newmatik-old/ntimer/README.md

# ntimer
Hard and Software for ERPNext time recording

We are working on the readme, meanwhile check out
`Ntimer API Documentation.docx`, `Ntimer Setup.docx` and the discussion post on the 
ERPNext forum here https://discuss.erpnext.com/t/hardware-employee-time-tracking-with-rfid-chips/39166/48
