newmatik-old/ntimer/Ntimer API Documentation.docx

# Ntimer API Documentation

Important: all API calls must be made by “Post” and can not be done by “Get”.

All responses are enveloped in a "message": [{ array }]

Example:

"message": [{

"status": "error",

"error_message": “RFID tag unknown."

}]

# Logging In

## API Call:

Logging In:

/api/method/login?usr=user&pwd=password

## Possible outcome:

- Logged in: "message": "Logged In"
- Not logged in: long HTML response with text “Your session has expired, please login again to continue". This could mean wrong username or password.

# Punch In or Punch Out:

## API Call:

Punch In:

/api/method/erpnext.hr.doctype.employee_checkin.employee_checkin.punch_in?rfid_tag=tag

Punch Out:

/api/method/erpnext.hr.doctype.employee_checkin.employee_checkin.punch_out?rfid_tag=tag

## Possible errors:

This RFID Tag is not set in any employee DocType.

"status": "error",

“error_message": “RFID tag unknown."

The employee is not active in the employee DocType.

“status": “error",

“error_message": “Employee not active."

Can not punch in because employee is already punched in.

“status": “error",

“error_message": “Already punched in."

Can not punch out because employee is not punched in.

“status": “error",

“error_message": “Not punched in."

Positive result punch In:

"status": "success",

"in_time": "2018-08-24 10:18:36",

"employee_name": "Michael Miller",

“rfid_tag": “123456789"

Positive result punch out:

"status": "success",

"out_time": "2018-08-24 10:23:24",

"in_time": "2018-08-24 10:18:00",

"employee_name": "Michael Miller",

"duration": "0:05:24",

"rfid_tag": "123456789"
