newmatik-old/ntimer/Hardware/Assembly and Fabrication files/Ntimer_Project_v1.0_BOM.xlsx

Designator | Comment | Manufacturer Part Number | Footprint | Quantity
C1, C2, C13, C14 | 22pF | 885012006004 | C0603 | 4
C3, C4, C5, C6, C7, C8, C9, C10, C11, C16, C17, C22, C23, C24, C25, C26, C27, C28, C29, C39, C40 | 100nF | CL10F104ZO8NNNC | C0603 | 21
C12, C52, C53 | 1uF | CL10A105KQ8NNNC | C0603 | 3
C15, C33 | 4.7uF | C1608X5R1C475M080AC, CL10A475MP5LNNC | C0603 | 2
C18, C19 | 22uF | CL10A226MQ8NRNC | C0603 | 2
C20 | 56pF | CL10C560JB8NNNC | C0603 | 1
C21 | 10uF | JMK107ABJ106MA-T | C0603 | 1
C30 | 22nF | CL10B223KA8NNWC | C0603 | 1
C31, C32 | 6.8nF | CL10B682KB8SFNC | C0603 | 2
C34, C35 | 10nF | VJ0603Y103KXQCW1BC | C0603 | 2
C36 | 1nF/2kV | C1206C102KGRACAUTO | R1206 | 1
C37, C38, C42, C49 | 18pF | VJ0603A180JXACW1BC | C0603 | 4
C41 | 1nF | CL10B102JB8NNNC | C0603 | 1
C43, C46, C54, C55 | 220pF | 885012206030 | C0603 | 4
C44, C47 | 47pF | 885012006021 | C0603 | 2
C45, C48 | 6.8pF | CL10C6R8DB8NNNC | C0603 | 2
C50, C51 | 15pF | CL10C150JC8NNNC | C0603 | 2
D1, D6 | 1N4148WT-7 | 1N4148WT-7 | SOD523 | 2
D2 | LED | LTST-S220GKT | LED0805 | 1
D3 | TX | LTST-S220GKT | LED0805 | 1
D4 | RX | LTST-C171KRKT | LED0805 | 1
D5 | 3V3 | LTST-S220GKT | LED0805 | 1
DS1 | NHD-C0220BIZ-FSW-FBW-3V3M | NHD-C0220BIZ-FSW-FBW-3V3M | NHD-C0220BIZ-FSW-FBW-3V3M | 1
J1 | PJ-037AH | PJ-037AH | CON_PJ-037A | 1
L1, L3, L4 | 120R | BLM18PG121SN1D | L0603 | 3
L2 | 10uH/3.4A/61m | VLS6045EX-100M | IND6045 | 1
L5, L6 | 560nH | AIML-0603-R56K-T | L0603 | 2
LS1 | PIEZO 65dB @ 1.5V, 10cm | PKMCS0909E4000-R1 | PIEZO_XDCR_PKMCS0909E4000-R1 | 1
P1 | ICSP | 5-146254-3 | HDR2X3 | 1
P2 | ICSP USB | 5-146254-3 | HDR2X3 | 1
P3 | Micro USB | 1051330011 | CON_MOLEX_105133-0011 | 1
P4 | RJMG1BD3B8K1ANR | RJMG1BD3B8K1ANR | CONN_RJMG1BD3B8K1ANR_RJMG1BD3B8K1ANR(Primary) | 1
P5 | 0472192001 | 0472192001 | MICROSD_MOLEX_0472192001 | 1
Q1, Q2 | MMBT3904-TP | MMBT3904-TP | SOT23-3 | 2
R1, R2 | 0R/DNP | CR0603-J/-000ELF | R0603 | 2
R3, R4, R25, R26, R27, R36, R42, R43, R44, R46 | 10k | RMCF0603FT10K0 | R0603 | 10
R5, R6, R9, R17, R37, R41, R45 | 1k | RMCF0603FG1K00 | R0603 | 7
R7, R8 | 22R | CRGCQ0603J22R | R0603 | 2
R10, R12, R13, R21, R33 | 330R | RMCF0603JT330R | R0603 | 5
R11, R35 | 1M | RMCF0603FG1M00 | R0603 | 2
R14 | 511k | RMCF0603FT511K | R0603 | 1
R15 | 105k | RMCF0603FT105K | R0603 | 1
R16, R22, R23, R31, R32 | 49.9R | RMCF0603FT49R9 | R0603 | 5
R18 | 100k | CR0603-JW-104ELF | R0603 | 1
R19 | 22.1k | RNCP0603FTD22K1 | R0603 | 1
R20 | 10R | RMCF0603JT10R0 | R0603 | 1
R24, R28, R29, R30 | 0R | CR0603-J/-000ELF | R0603 | 4
R34 | 12.4k | RMCF0603FT12K4 | R0603 | 1
R38 | 5.36k | CR0603-FX-5361ELF | R0603 | 1
R39, R40 | 4.7k | RMCF0603JT4K70 | R0603 | 2
R47, R48 | 3.3R | CRGCQ0603J3R3 | R0603 | 2
S1 | SPST-NO | PTS645SM43SMTR92 LFS | DPST-4 | 1
S2 | SPST-NO | D6R50 F1 LFS | BUTTON_D6R90_GREEN | 1
S3 | SPST-NO | D6R40 F1 LFS | BUTTON_D6R90_RED | 1
U1 | ATMEGA2560-16AU | ATMEGA2560-16AU | TQFP100 | 1
U2 | ATMEGA16U2-AU | ATMEGA16U2-AU | 32A_N | 1
U3 | TPS54202DDCT | TPS54202DDCT | SOT23-6 | 1
U4 | W5500 | W5500 | QFP50P700X700X160-48N | 1
U5 | MFRC52201HN1,157 | MFRC52201HN1,157 | QFN-32_5x5_0.5 | 1
Y1, Y2 | XTAL 16MHz | ABLS-16.000MHZ-B2-T | XTAL-SMD | 2
Y3 | 25MHz | ABM3-25.000MHZ-D2Y-T | CRYSTAL-AMB3_5X3.2_1.3 | 1
Y4 | XTAL 27.12MHz | 9C-27.120MAAJ-T | XTAL-SMD | 1
