newmatik-old/ntimer/Case/case/PCB case.SLDASM

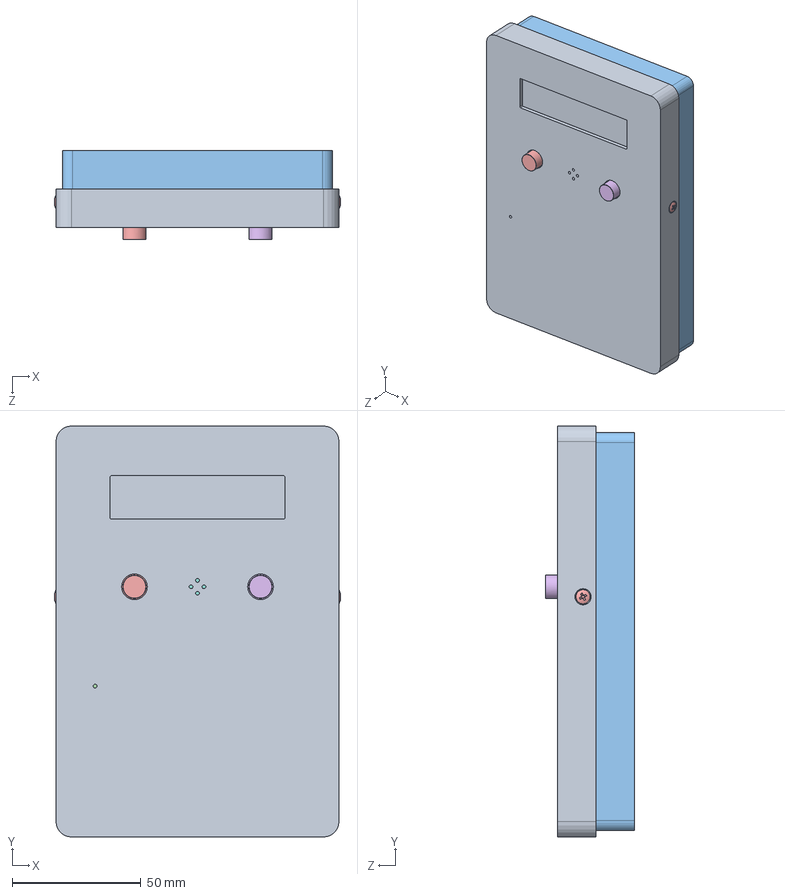
[picture p1: CAD file, 2018-10-25]
Case/case/PCB case.SLDASM
111.3 x 159.8 x 34.6 mm
case front
Board
C0603 x 54
R0603 x 48
User_Library-RES_3216-1206
User_Library-SOD-523F x 2
User_Library-User_Library-led_0805_GRE x 4
1112W-3
LCD
PRT0001 x 8
PJ-037A
PJ-037A_2
PJ-037A_3
User_Library-Chip_Inductor_0603 x 5
User_Library-Inductor_VLC6045_Series
PKMCS0909E4000-R1--3DModel-STEP-56544
SOT-23 x 2
b3s-1000
D6R90F1LFS_RGB65280
D6R90F1LFS_RGB255
User_Library-TQFP100_Grid_0.5_TQFP100_Koerper_2
User_Library-TQFP100_Grid_0.5_TQFP_PIN_2 x 100
SW3dPS-SW3dPS-atmega8_(tqfp32)_V2008
User_Library-SOT23-6-2
User_Library-WIZNET_W5500
User_Library-qfn32-5x5____________
ABLS x 3
User_Library-ABM3_BodyBase
User_Library-ABM3_TopCap
User_Library-ABM3_Pocket001
User_Library-ABM3_Pocket
User_Library-J1B1211CCD
case back
pan head cross recess screw_iso x 4
countersunk raised head cross recess screw_iso x 2
