newmatik-old/ntimer/Case/case/case back.SLDPRT

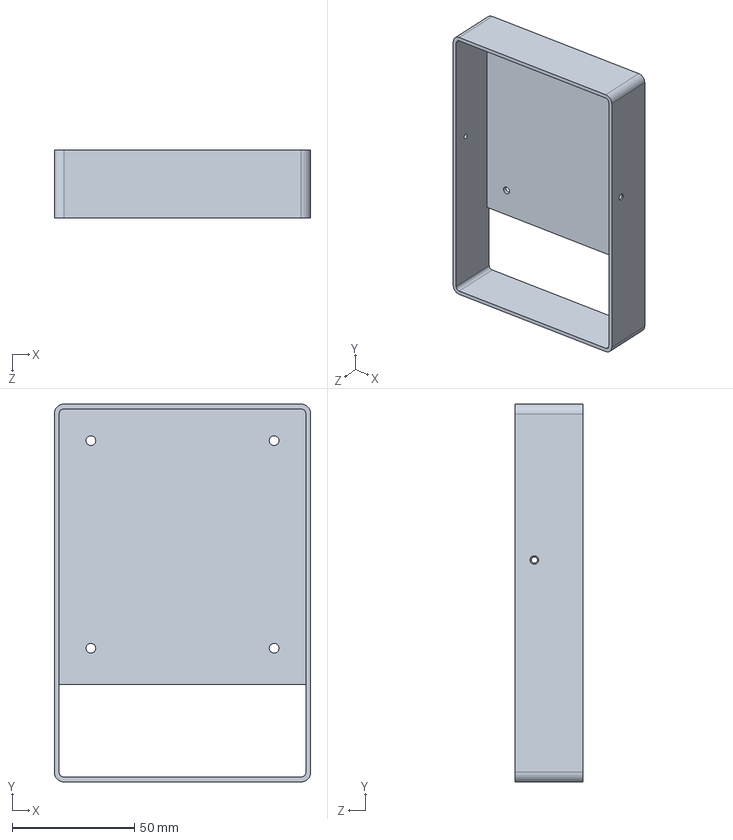
[picture p3: CAD file, 2018-10-25]
Case/case/case back.SLDPRT
105.0 x 154.8 x 28.0 mm
