newmatik-old/ntimer/Case/case/case front.SLDPRT

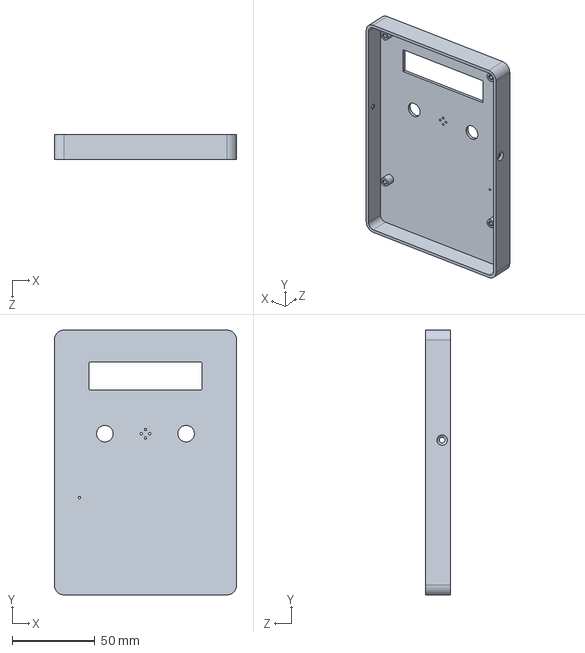
[picture p4: CAD file, 2018-10-25]
Case/case/case front.SLDPRT
110.0 x 159.8 x 15.0 mm
