newmatik-old/ntimer/(list of files, cad)

Other CAD files:
Case/model/U2.sldasm
Case/model/R24.sldasm
Case/model/S2.sldasm
Case/model/C23.sldasm
Case/model/C34.sldasm
Case/model/C43.sldasm
Case/model/S1.sldasm
Case/model/R9.sldasm
Case/model/R23.sldasm
Case/model/U3.sldasm
Case/model/R26.sldasm
Case/model/R34.sldasm
Case/model/R32.sldasm
Case/model/P5.sldasm
Case/model/C32.sldasm
Case/model/R11.sldasm
Case/model/C31.sldasm
Case/model/P4.sldasm
Case/model/C35.sldasm
Case/model/C21.sldasm
Case/model/C39.sldasm
Case/model/C30.sldasm
Case/model/C1.sldasm
Case/model/C9.sldasm
Case/model/C13.sldasm
Case/model/C27.sldasm
Case/model/D5.sldasm
Case/model/C12.sldasm
Case/model/R19.sldasm
Case/model/R6.sldasm
Case/model/R2.sldasm
Case/model/Q2.sldasm
Case/model/L5.sldasm
Case/model/R40.sldasm
Case/model/P3.sldasm
Case/model/Y3.sldasm
Case/model/L2.sldasm
Case/model/Y1.sldasm
Case/model/C49.sldasm
Case/model/L4.sldasm
Case/model/C7.sldasm
Case/model/D3.sldasm
Case/model/Y4.sldasm
Case/model/R30.sldasm
Case/model/C52.sldasm
Case/model/C40.sldasm
Case/model/C2.sldasm
Case/model/R42.sldasm
Case/model/R18.sldasm
Case/model/R27.sldasm
Case/model/R41.sldasm
Case/model/C37.sldasm
Case/model/C47.sldasm
Case/model/C44.sldasm
Case/model/C24.sldasm
Case/model/U1.sldasm
Case/model/C51.sldasm
Case/model/Q1.sldasm
Case/model/R44.sldasm
Case/model/U5.sldasm
Case/model/C15.sldasm
Case/model/DS1.sldasm
Case/model/C26.sldasm
Case/model/R10.sldasm
Case/model/C0603.sldasm
Case/model/LS1.sldasm
Case/model/R16.sldasm
Case/model/R47.sldasm
Case/model/C36.sldasm
Case/model/R39.sldasm
Case/model/R28.sldasm
Case/model/R4.sldasm
Case/model/R33.sldasm
Case/model/R14.sldasm
Case/model/R43.sldasm
Case/model/R48.sldasm
Case/model/U4.sldasm
Case/model/R35.sldasm
Case/model/C11.sldasm
Case/model/User_Library-ABM3.sldasm
Case/model/D6.sldasm
Case/model/R25.sldasm
Case/model/C41.sldasm
Case/model/R46.sldasm
Case/model/C16.sldasm
Case/model/C3.sldasm
Case/model/C28.sldasm
Case/model/C53.sldasm
Case/model/R37.sldasm
Case/model/R17.sldasm
Case/model/C38.sldasm
Case/model/R7.sldasm
Case/model/Y2.sldasm
Case/model/L3.sldasm
Case/model/C17.sldasm
Case/model/R36.sldasm
Case/model/L6.sldasm
Case/model/C55.sldasm
Case/model/C5.sldasm
Case/model/C4.sldasm
Case/model/NHD-C0220BiZ-FSW-FBW-3V3M.sldasm
Case/model/SOT-23.sldasm
Case/model/R31.sldasm
Case/model/R15.sldasm
Case/model/S3.sldasm
Case/model/R0603.sldasm
Case/model/C50.sldasm
Case/model/C18.sldasm
Case/model/R38.sldasm
Case/model/R8.sldasm
Case/model/C33.sldasm
Case/model/C46.sldasm
Case/model/R13.sldasm
Case/model/C22.sldasm
Case/model/R21.sldasm
Case/model/D2.sldasm
Case/model/C45.sldasm
Case/model/C54.sldasm
Case/model/C25.sldasm
Case/model/R12.sldasm
Case/model/R1.sldasm
Case/model/C20.sldasm
Case/model/R5.sldasm
Case/model/C14.sldasm
Case/model/C6.sldasm
Case/model/C29.sldasm
Case/model/J1.sldasm
Case/model/C8.sldasm
Case/model/R22.sldasm
Case/model/R20.sldasm
Case/model/R45.sldasm
Case/model/D4.sldasm
Case/model/C19.sldasm
Case/model/C10.sldasm
Case/model/C48.sldasm
Case/model/C42.sldasm
Case/model/User_Library-TQFP100_Grid_0_5.sldasm
Case/model/L1.sldasm
Case/model/R3.sldasm
Case/model/R29.sldasm
Case/model/D1.sldasm
Case/model/User_Library-User_Library-led_0805_GRE.sldprt
Case/model/User_Library-qfn32-5x5____________.sldprt
Case/model/PKMCS0909E4000-R1--3DModel-STEP-56544.sldprt
Case/model/User_Library-RES_3216-1206.sldprt
Case/model/User_Library-TQFP100_Grid_0.5_TQFP_PIN_2.sldprt
Case/case/case back.STL
Case/case/case front.STL
Case/case/pan head cross recess screw_iso.sldprt
Case/model/1051330011.sldasm
Case/model/1112W-3.sldprt
Case/model/472192001.sldasm
Case/model/ABLS.sldprt
Case/model/Board.sldprt
Case/model/C0603.sldprt
Case/model/D6R90F1LFS_RGB255.sldprt
Case/model/D6R90F1LFS_RGB65280.sldprt
Case/model/LCD.sldprt
Case/model/Open CASCADE STEP translator 6.8 2.74.1.1.sldprt
Case/model/Open CASCADE STEP translator 6.8 2.75.1.1.sldprt
Case/model/PJ-037A.sldprt
Case/model/PJ-037A_2.sldprt
Case/model/PJ-037A_3.sldprt
Case/model/PRT0001.sldprt
Case/model/R0603.sldprt
Case/model/SOT-23.sldprt
Case/model/SW3dPS-SW3dPS-atmega8_(tqfp32)_V2008.sldprt
Case/model/User_Library-ABM3_BodyBase.sldprt
Case/model/User_Library-ABM3_Pocket.sldprt
Case/model/User_Library-ABM3_Pocket001.sldprt
Case/model/User_Library-ABM3_TopCap.sldprt
Case/model/User_Library-Chip_Inductor_0603.sldprt
Case/model/User_Library-Inductor_VLC6045_Series.sldprt
Case/model/User_Library-J1B1211CCD.sldprt
Case/model/User_Library-SOD-523F.sldprt
Case/model/User_Library-SOT23-6-2.sldprt
Case/model/User_Library-TQFP100_Grid_0.5_TQFP100_Koerper_2.sldprt
Case/model/User_Library-WIZNET_W5500.sldprt
Case/model/b3s-1000.sldprt
