newmatik-old/ntimer/Hardware/Assembly and Fabrication files/Ntimer_Stack_v1.0.xls

Board Stack Report
Stack Up |  | Layer Stack
Layer | Board Layer Stack | Name | Material | Thickness | Constant
1 |  | Top Paste
2 |  | Top Overlay
3 |  | Top Solder | Solder Resist | 0.025mm | 3.3
4 |  | Top Layer | Copper | 0.036mm
5 |  | Dielectric 1 | FR408 prepreg | 0.170mm | 3.66
6 |  | GND | Copper | 0.018mm
7 |  | Dielectric 3 | FR408 core | 1.194mm | 3.66
8 |  | PWR | Copper | 0.018mm
9 |  | Dielectric 2 | FR408 prepreg | 0.170mm | 3.66
10 |  | Bottom Layer | Copper | 0.036mm
11 |  | Bottom Solder | Solder Resist | 0.025mm | 3.3
12 |  | Bottom Overlay
13 |  | Bottom Paste
 | Height : 1.692mm
