newmatik-old/ntimer/Hardware/Assembly and Fabrication files/Ntimer_Project_v1.0_SCH.pdf

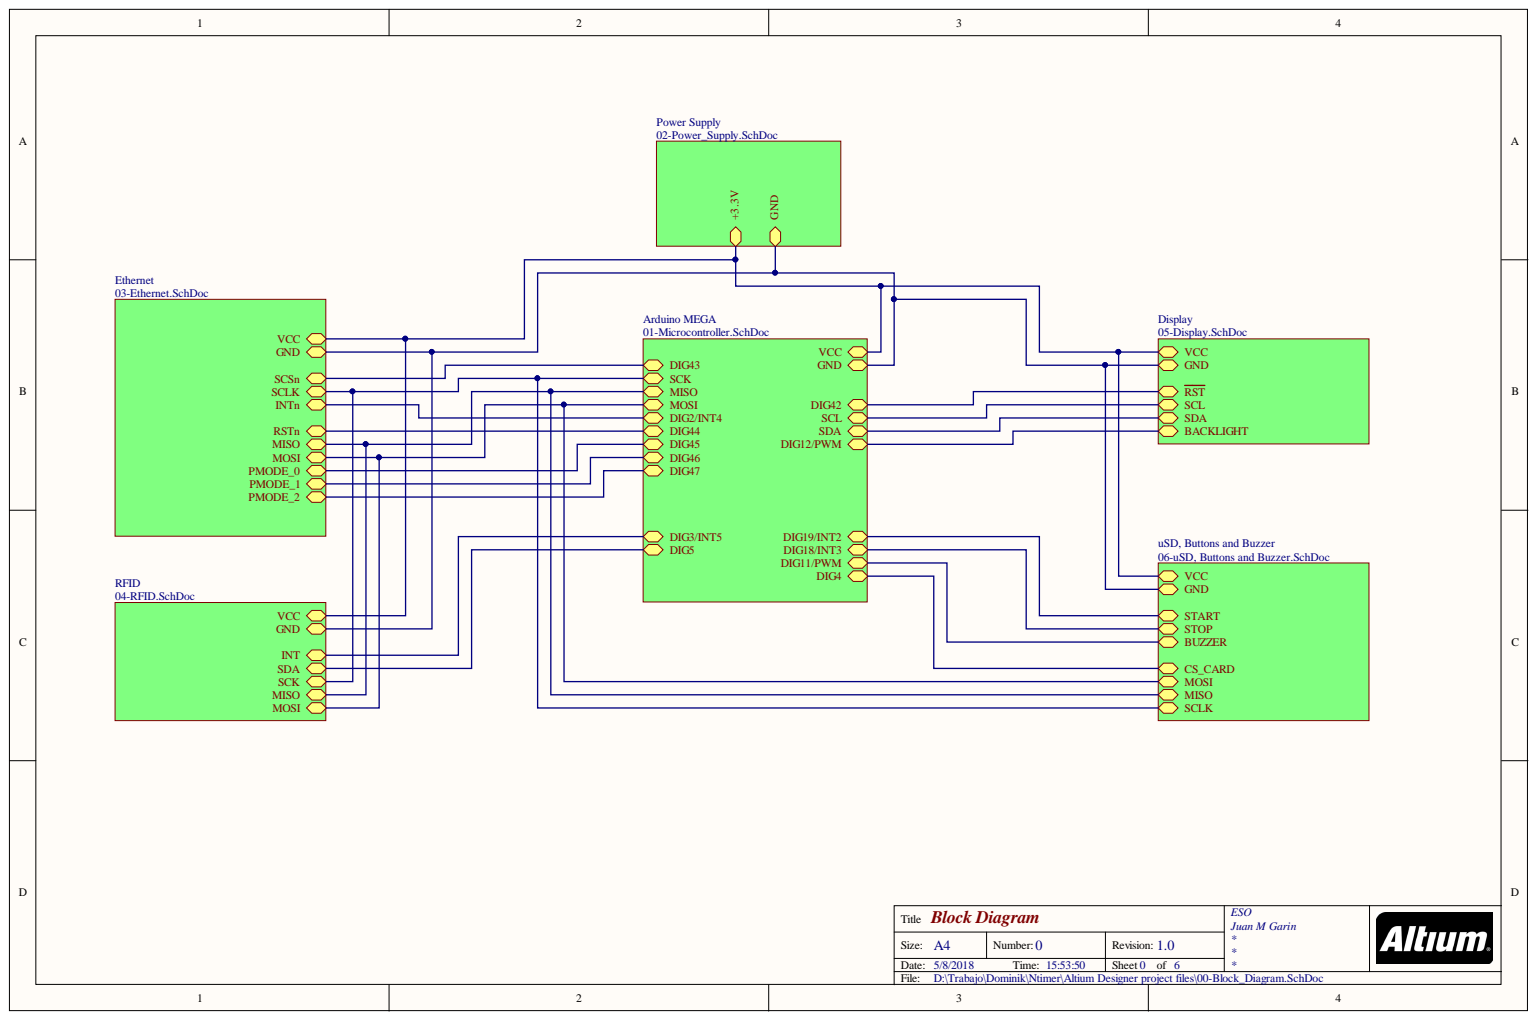
[picture p11: page 1]

MISO
MOSI DIG42 DIG2/INT4 SCL DIG44 SDA DIG45 DIG12/PWM DIG46 DIG47 DIG3/INT5 DIG19/INT2 DIG5 DIG18/INT3 DIG11/PWM DIG4

uSD, Buttons and Buzzer
06-uSD, Buttons and Buzzer.SchDoc
VCC
GND

Block Diagram Title | ESO Juan M Garin * *

Size: A4 | Number: 0 | Revision: 1.0

Date: 5/8/2018 Time: 15:53:50 | | Sheet of

D:\Trabajo\Dominik\Ntimer\Altium Designer project files\00-Block_Diagram.SchDoc

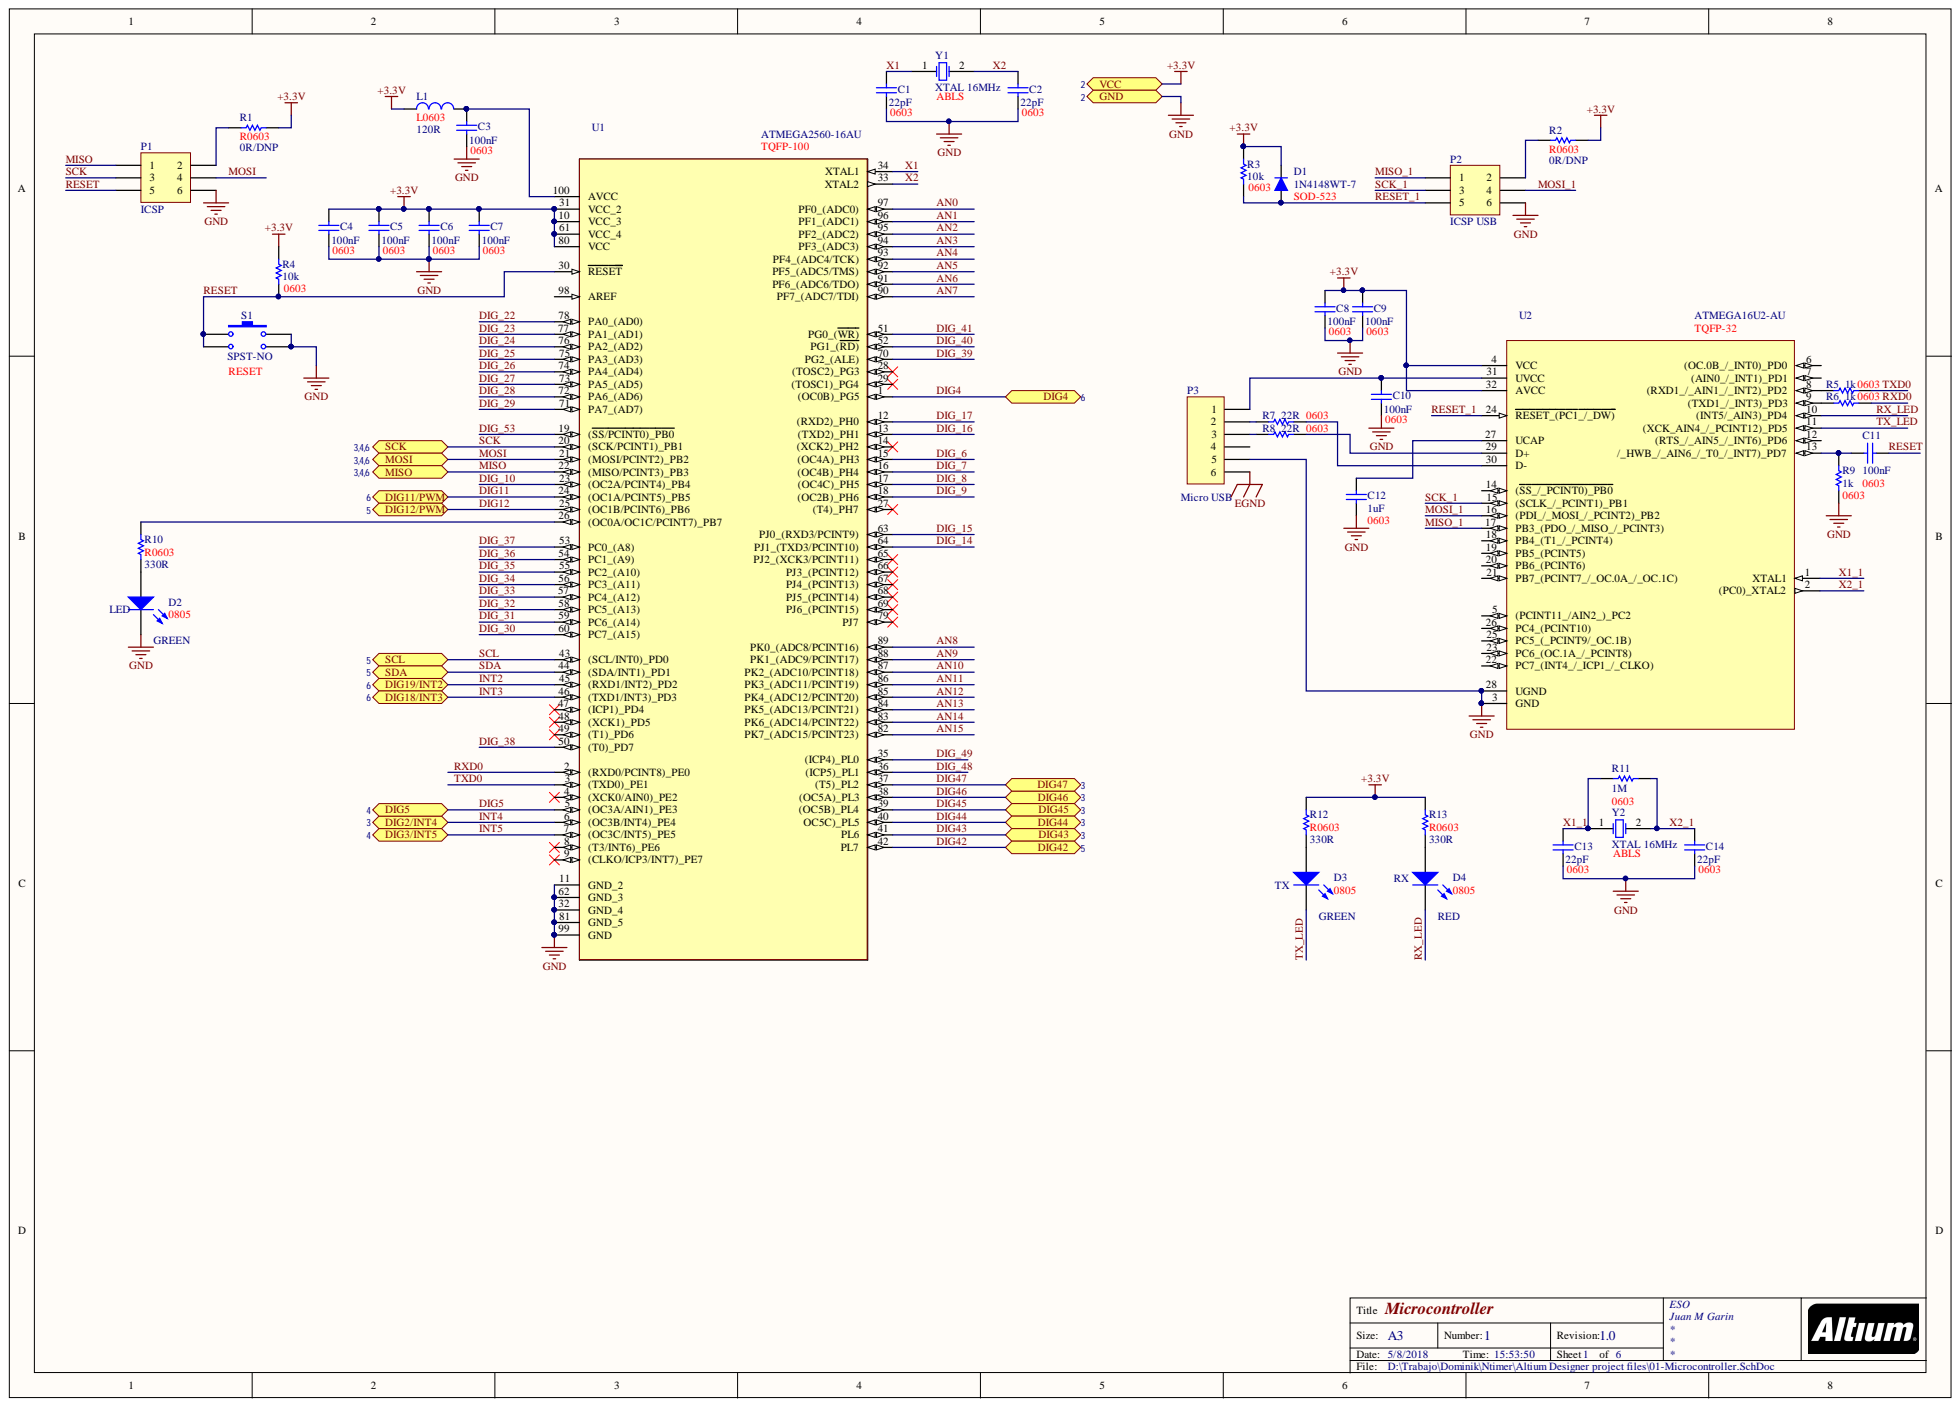
[picture p12: page 2]

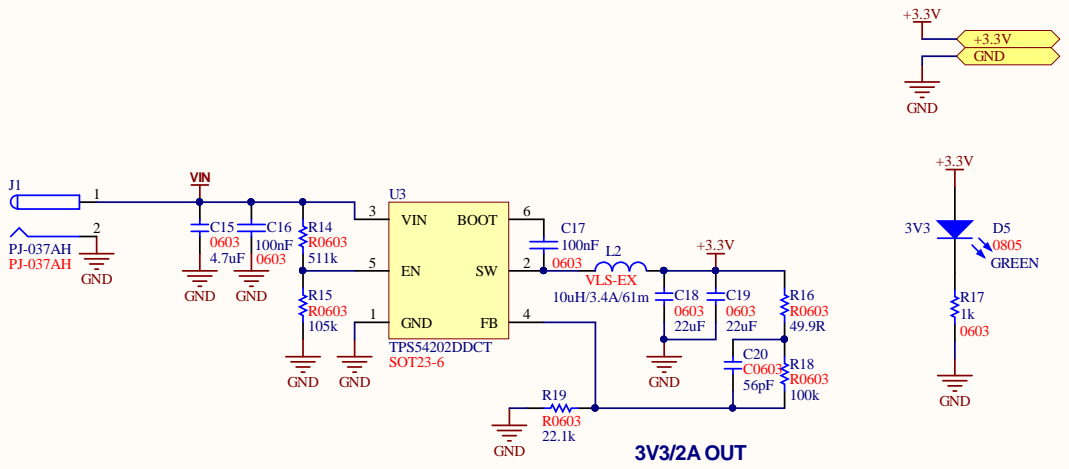
[picture p13: page 3]

Pow e r S upply Titl e | ESO Juan M Ga r i n **

S ize : A4 | Nu mb er: 2 | R e vi s ion : 1.0

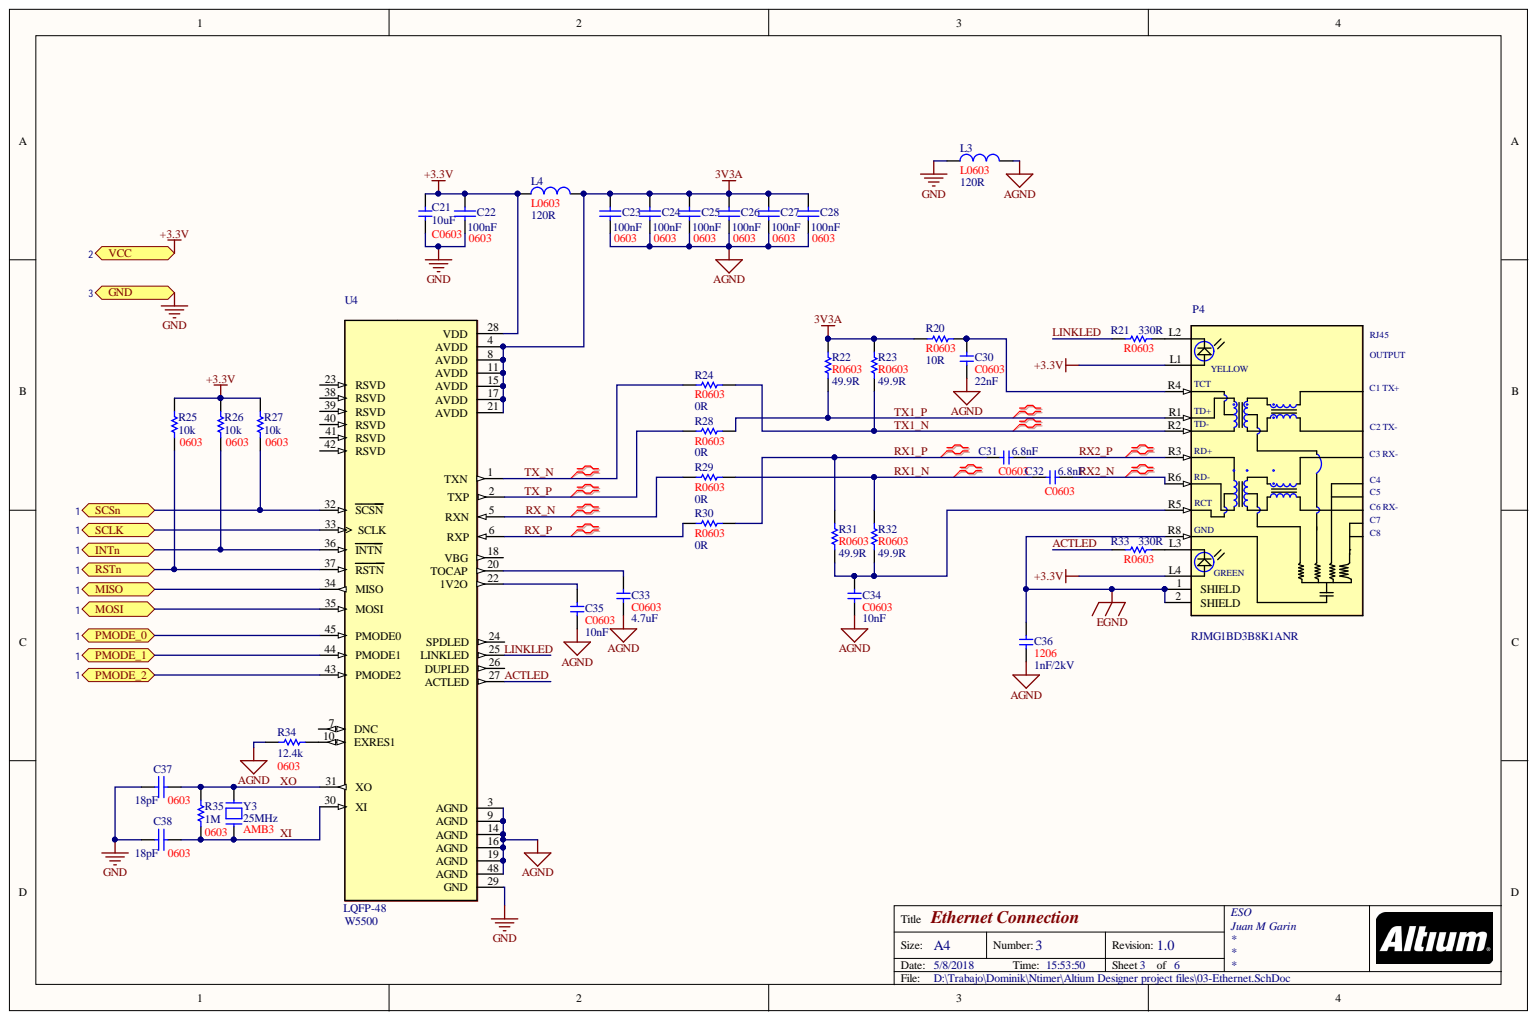
[picture p14: page 4]

Ethernet Connection Title | ESO Juan M Garin * *

Size: A4 | Number: 3 | Revision: 1.0

D:\Trabajo\Dominik\Ntimer\Altium Designer project files\03-Ethernet.SchDoc

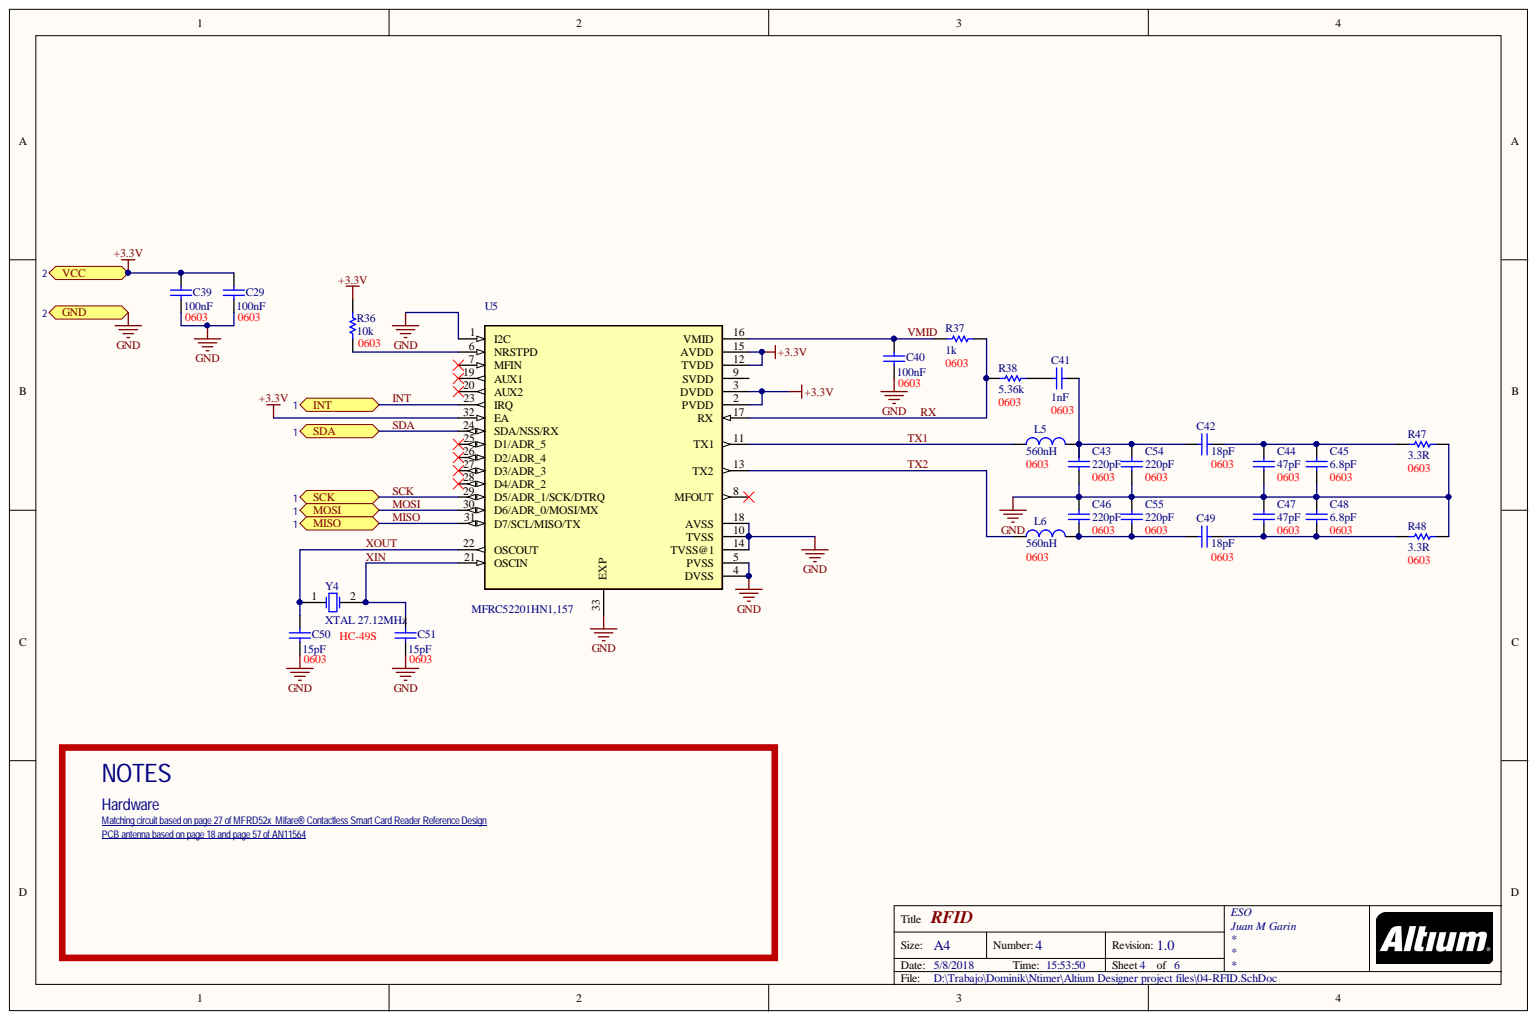
[picture p15: page 5]

R FID Titl e | ESO Juan M Ga r i n **

S ize : A4 | Nu mb er: 4 | R e vi s ion : 1.0

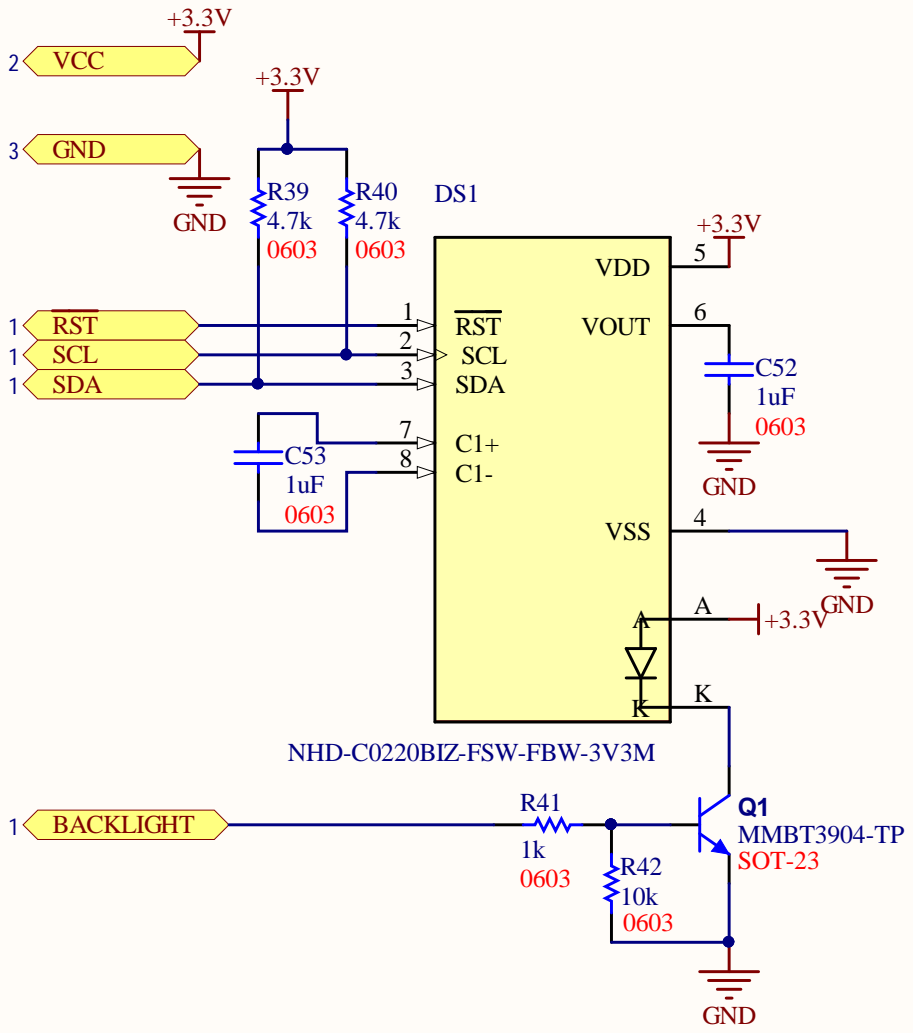
[picture p16: page 6]

Display Title | ESO Juan M Garin * *

Size: A4 | Number: 5 | Revision: 1.0

D:\Trabajo\Dominik\Ntimer\Altium Designer project files\05-Display.SchDoc

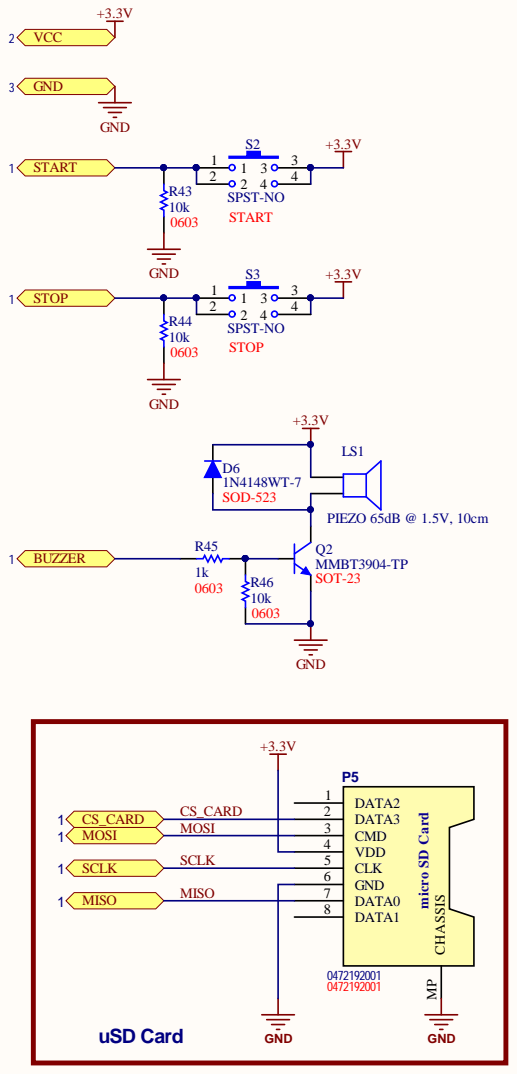
[picture p17: page 7]

uSD, Buttons and Buzzer
Title

D:\Trabajo\Dominik\Ntimer\Altium Designer project files\06-uSD, Buttons and Buzzer.SchDoc
