newmatik-old/ntimer/Hardware/Modifications/RFID_v1.2.pdf

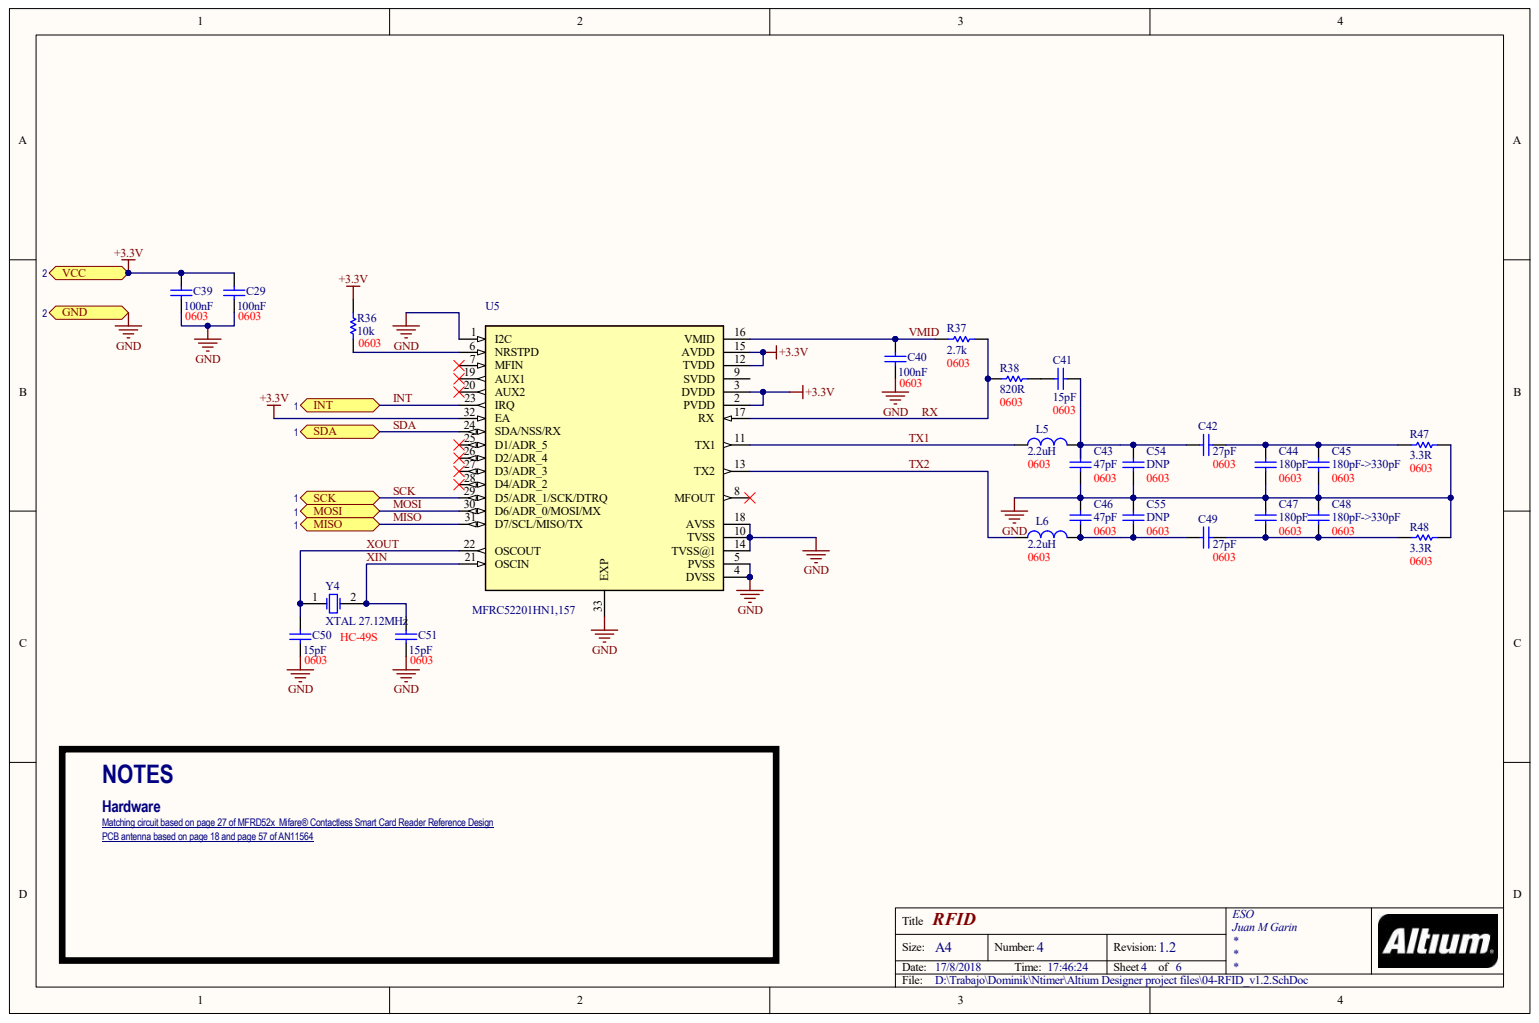
[picture p18: page 1]

Hardware
Matching circuit based on page 27 of MFRD52x Mifare® Contactless Smart Card Reader Reference Design
PCB antenna based on page 18 and page 57 of AN11564

D:\Trabajo\Dominik\Ntimer\Altium Designer project files\04-RFID_v1.2.SchDoc
