newmatik-old/ntimer/Hardware/Assembly and Fabrication files/Assembly Drawings_v1.0.pdf

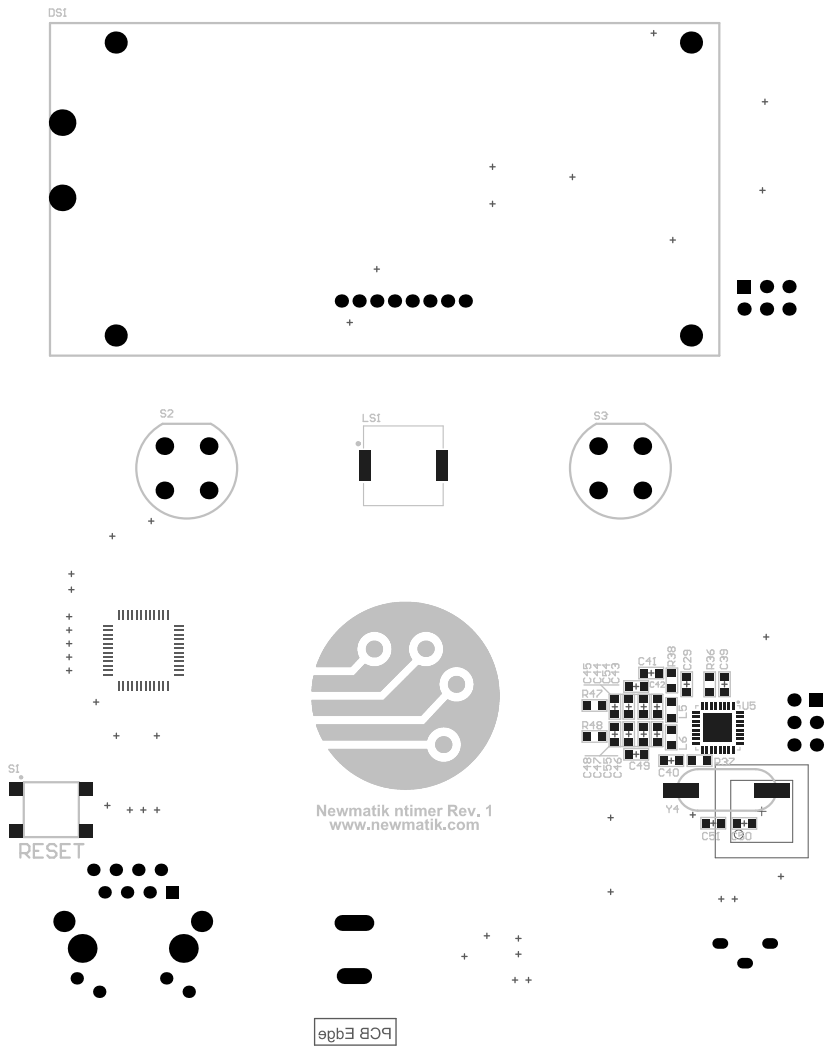
[picture p19: page 1]

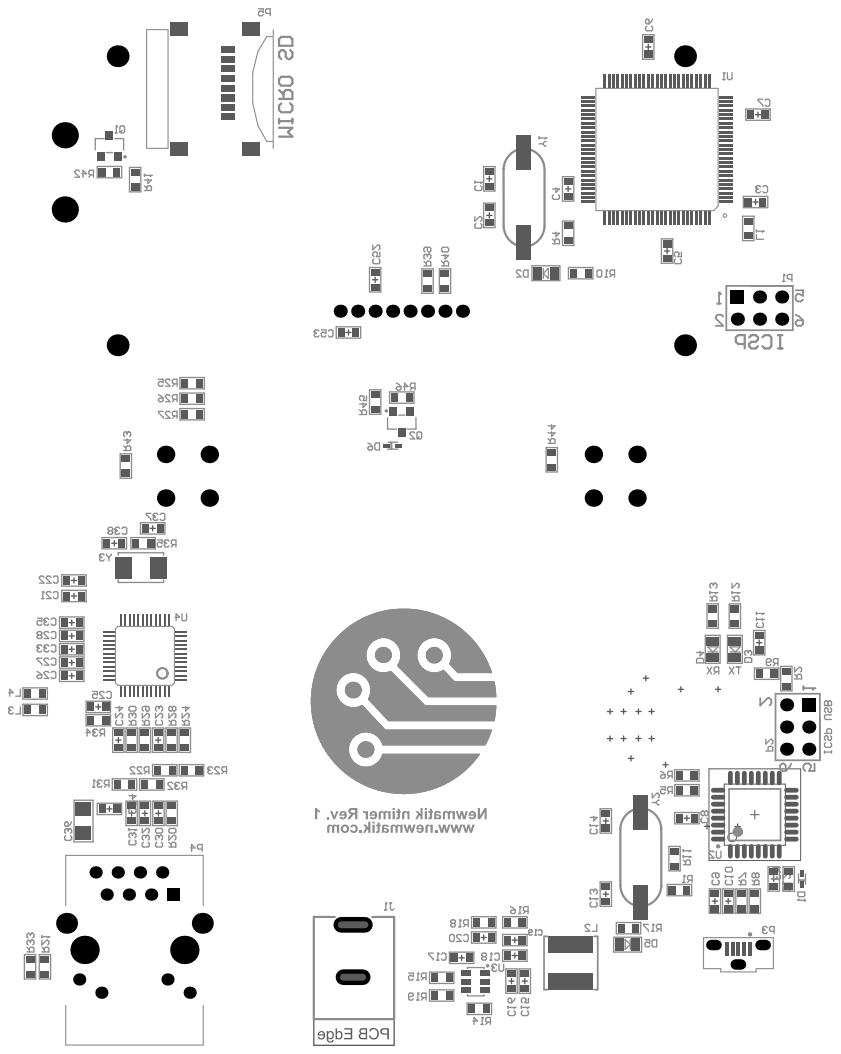
[picture p20: page 2]
