newmatik-old/ntimer/Hardware/Assembly and Fabrication files/Composite Drill Drawing_v1.0.pdf

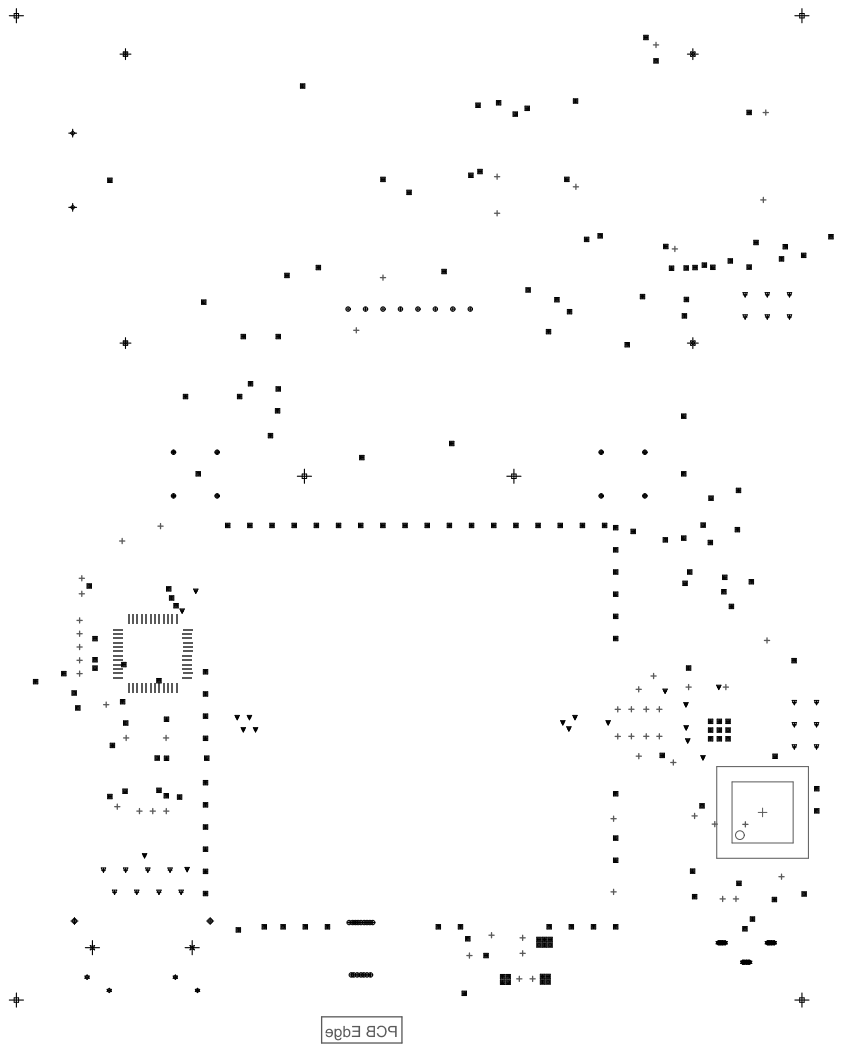
[picture p21: page 1]
