newmatik-old/ntimer/Hardware/Assembly and Fabrication files/Drill Guides_v1.0.pdf

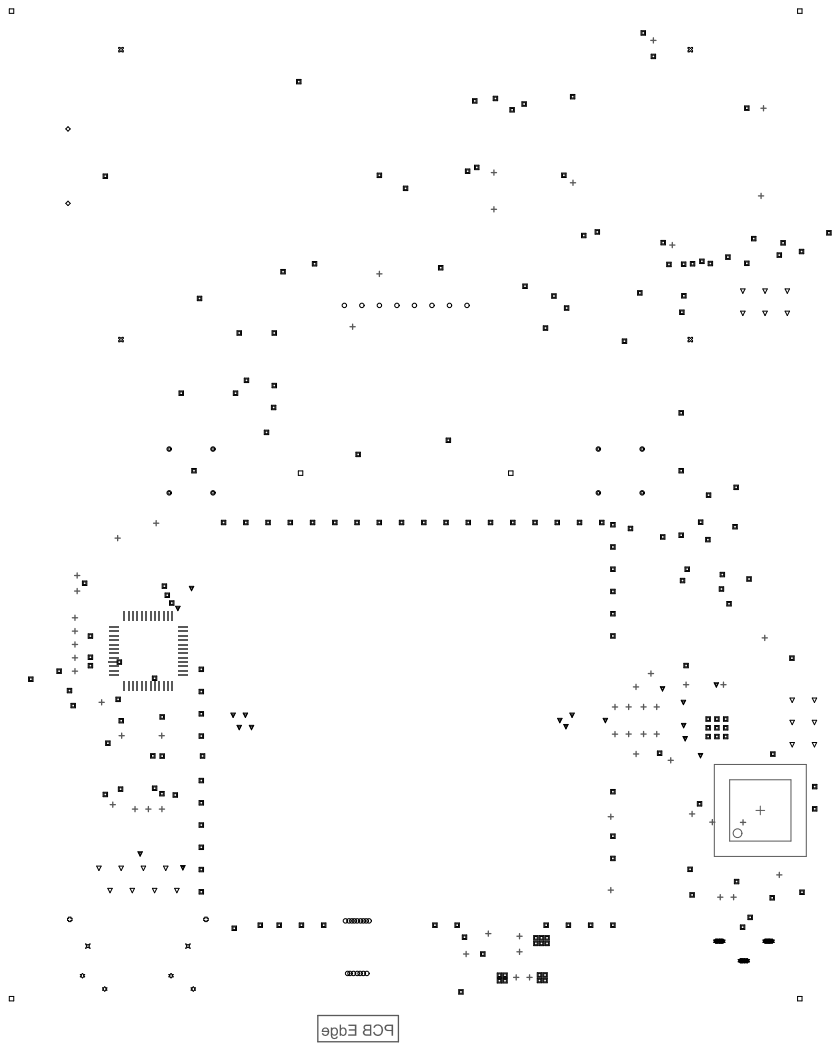
[picture p22: page 1]

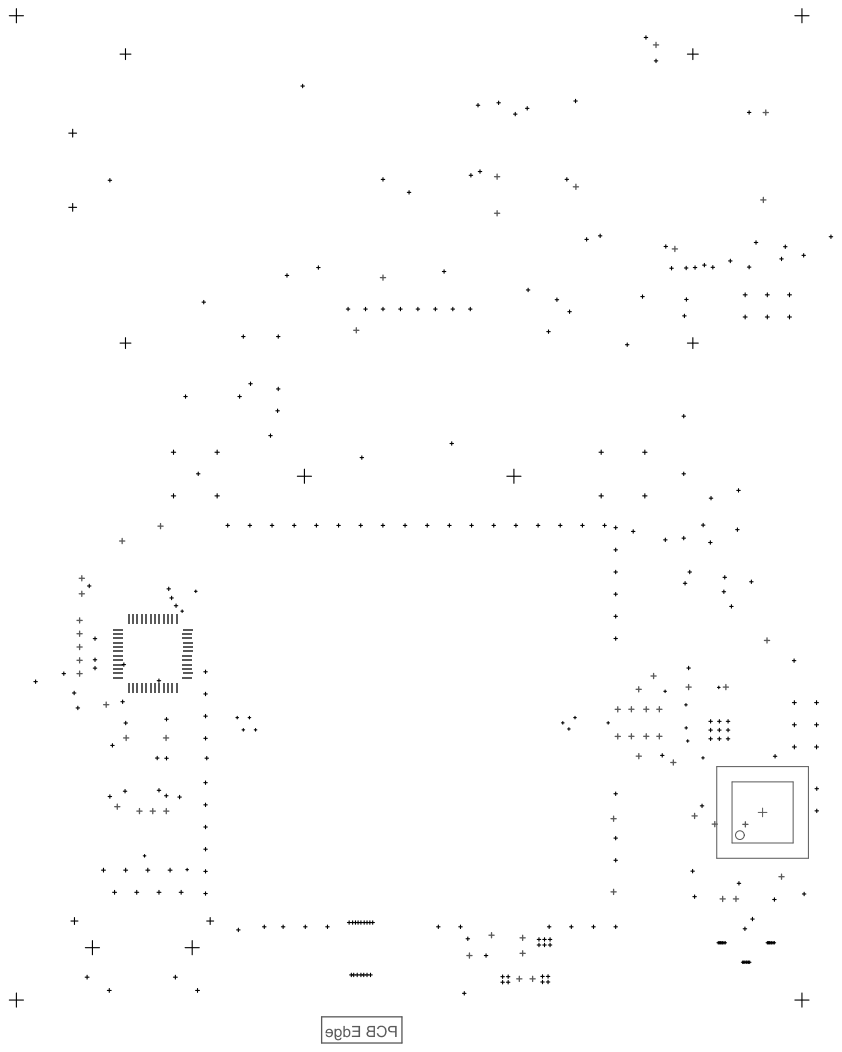
[picture p23: page 2]
