newmatik-old/ntimer/(list of files, drawings)

Other design files:
Hardware/Altium Designer Project Files/00-Block_Diagram.SchDoc
Hardware/Altium Designer Project Files/01-Microcontroller.SchDoc
Hardware/Altium Designer Project Files/02-Power_Supply.SchDoc
Hardware/Altium Designer Project Files/03-Ethernet.SchDoc
Hardware/Altium Designer Project Files/04-RFID.SchDoc
Hardware/Altium Designer Project Files/05-Display.SchDoc
Hardware/Altium Designer Project Files/06-uSD, Buttons and Buzzer.SchDoc
Hardware/Altium Designer Project Files/Ntimer_Project.PrjPcb
