newmatik-old/ntimer/Software/Main/src/Ethernet2/EthernetUdp2.cpp

/*
 *  Udp.cpp: Library to send/receive UDP packets with the Arduino ethernet shield.
 *  This version only offers minimal wrapping of socket.c/socket.h
 *  Drop Udp.h/.cpp into the Ethernet library directory at hardware/libraries/Ethernet/ 
 *
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
 * bjoern@cs.stanford.edu 12/30/2008
 *
 * - 10 Apr. 2015
 * Added support for Arduino Ethernet Shield 2
 * by Arduino.org team
 */

#include "w5500.h"
#include "socket.h"
#include "Ethernet2.h"
#include "Udp.h"
#include "Dns.h"

/* Constructor */
EthernetUDP::EthernetUDP() : _sock(MAX_SOCK_NUM) {}

/* Start EthernetUDP socket, listening at local port PORT */
uint8_t EthernetUDP::begin(uint16_t port) {
  if (_sock != MAX_SOCK_NUM)
    return 0;

  for (int i = 0; i < MAX_SOCK_NUM; i++) {
    uint8_t s = w5500.readSnSR(i);
    if (s == SnSR::CLOSED || s == SnSR::FIN_WAIT) {
      _sock = i;
      break;
    }
  }

  if (_sock == MAX_SOCK_NUM)
    return 0;

  _port = port;
  _remaining = 0;
  socket(_sock, SnMR::UDP, _port, 0);

  return 1;
}

/* return number of bytes available in the current packet,
   will return zero if parsePacket hasn't been called yet */
int EthernetUDP::available() {
  return _remaining;
}

/* Release any resources being used by this EthernetUDP instance */
void EthernetUDP::stop()
{
  if (_sock == MAX_SOCK_NUM)
    return;

  close(_sock);

  EthernetClass::_server_port[_sock] = 0;
  _sock = MAX_SOCK_NUM;
}

int EthernetUDP::beginPacket(const char *host, uint16_t port)
{
  // Look up the host first
  int ret = 0;
  DNSClient dns;
  IPAddress remote_addr;

  dns.begin(Ethernet.dnsServerIP());
  ret = dns.getHostByName(host, remote_addr);
  if (ret == 1) {
    return beginPacket(remote_addr, port);
  } else {
    return ret;
  }
}

int EthernetUDP::beginPacket(IPAddress ip, uint16_t port)
{
  _offset = 0;
  return startUDP(_sock, rawIPAddress(ip), port);
}

int EthernetUDP::endPacket()
{
  return sendUDP(_sock);
}

size_t EthernetUDP::write(uint8_t byte)
{
  return write(&byte, 1);
}

size_t EthernetUDP::write(const uint8_t *buffer, size_t size)
{
  uint16_t bytes_written = bufferData(_sock, _offset, buffer, size);
  _offset += bytes_written;
  return bytes_written;
}

int EthernetUDP::parsePacket()
{
  // discard any remaining bytes in the last packet
  flush();

  if (w5500.getRXReceivedSize(_sock) > 0)
  {
    //HACK - hand-parse the UDP packet using TCP recv method
    uint8_t tmpBuf[8];
    int ret =0; 
    //read 8 header bytes and get IP and port from it
    ret = recv(_sock,tmpBuf,8);
    if (ret > 0)
    {
      _remoteIP = tmpBuf;
      _remotePort = tmpBuf[4];
      _remotePort = (_remotePort << 8) + tmpBuf[5];
      _remaining = tmpBuf[6];
      _remaining = (_remaining << 8) + tmpBuf[7];

      // When we get here, any remaining bytes are the data
      ret = _remaining;
    }
    return ret;
  }
  // There aren't any packets available
  return 0;
}

int EthernetUDP::read()
{
  uint8_t byte;

  if ((_remaining > 0) && (recv(_sock, &byte, 1) > 0))
  {
    // We read things without any problems
    _remaining--;
    return byte;
  }

  // If we get here, there's no data available
  return -1;
}

int EthernetUDP::read(unsigned char* buffer, size_t len)
{

  if (_remaining > 0)
  {

    int got;

    if (_remaining <= len)
    {
      // data should fit in the buffer
      got = recv(_sock, buffer, _remaining);
    }
    else
    {
      // too much data for the buffer, 
      // grab as much as will fit
      got = recv(_sock, buffer, len);
    }

    if (got > 0)
    {
      _remaining -= got;
      return got;
    }

  }

  // If we get here, there's no data available or recv failed
  return -1;

}

int EthernetUDP::peek()
{
  uint8_t b;
  // Unlike recv, peek doesn't check to see if there's any data available, so we must.
  // If the user hasn't called parsePacket yet then return nothing otherwise they
  // may get the UDP header
  if (!_remaining)
    return -1;
  ::peek(_sock, &b);
  return b;
}

void EthernetUDP::flush()
{
  // could this fail (loop endlessly) if _remaining > 0 and recv in read fails?
  // should only occur if recv fails after telling us the data is there, lets
  // hope the w5500 always behaves :)

  while (_remaining)
  {
    read();
  }
}
