newmatik-old/ntimer/(commit log)

2018-08-02 Switch to Mega, Ethernet and Debugging
    - Switch from Arduino Uno to Mega because of memory size and number of IO
    - Implementing ethernet and first tests
    - Add debugging statements to serial
2018-10-25 Initial Release
    [00-Block_Diagram.SchDoc, 01-Microcontroller.SchDoc, 02-Power_Supply.SchDoc, 03-Ethernet.SchDoc, 04-RFID.SchDoc, 05-Display.SchDoc, 06-uSD, Buttons and Buzzer.SchDoc, 1051330011.sldasm]
