newmatik-old/ntimer/(notices)

Notices in the files:
Software/Main/src/Ethernet2/EthernetUdp2.cpp:
MIT License:
Copyright (c) 2008 Bjoern Hartmann
